klekiMuendling/Motorcycle-chain-oiler-v2/foto/20260508_172321.jpg

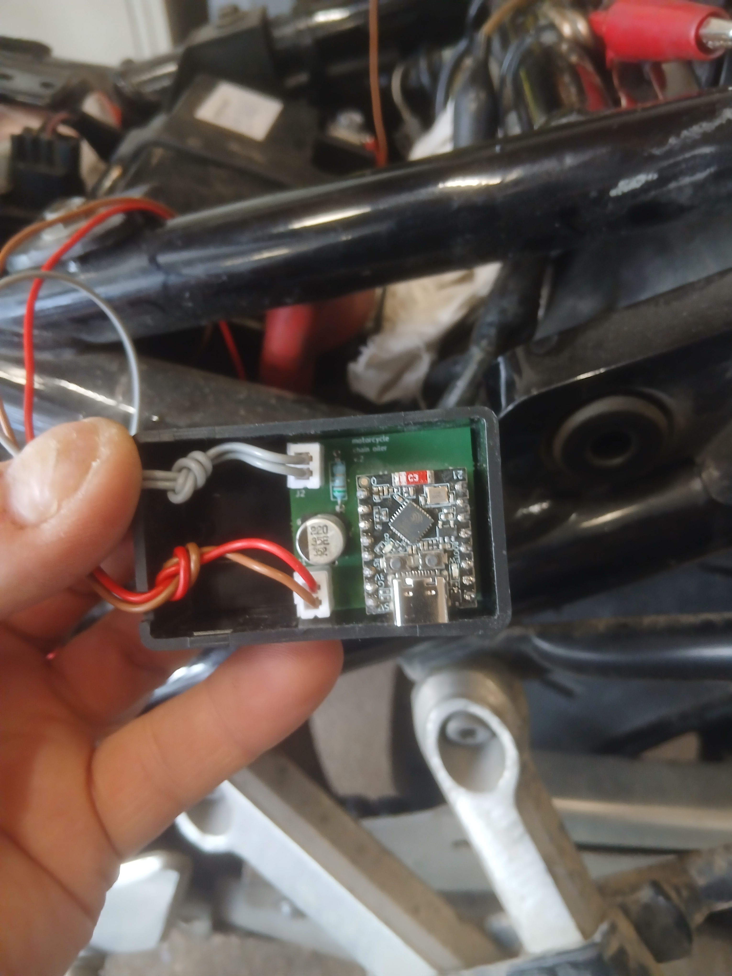
foto/20260508_172321.jpg
