klekiMuendling/Motorcycle-chain-oiler-v2/README.md

# Motorcycle-chain-oiler-v2
Chain oiler for motorbike chain - control PCB with ESP32 controled over Bluetooth
