klekiMuendling/Motorcycle-chain-oiler-v2/motorcycleChainOilerV2/README.md

# motorcycleChainOilerV2

## Description

This is a [LibrePCB](https://librepcb.org) project!
Just edit this file to add a description about it.

## License

No license set.
