klekiMuendling/Motorcycle-chain-oiler-v2/foto/20260508_181641.jpg

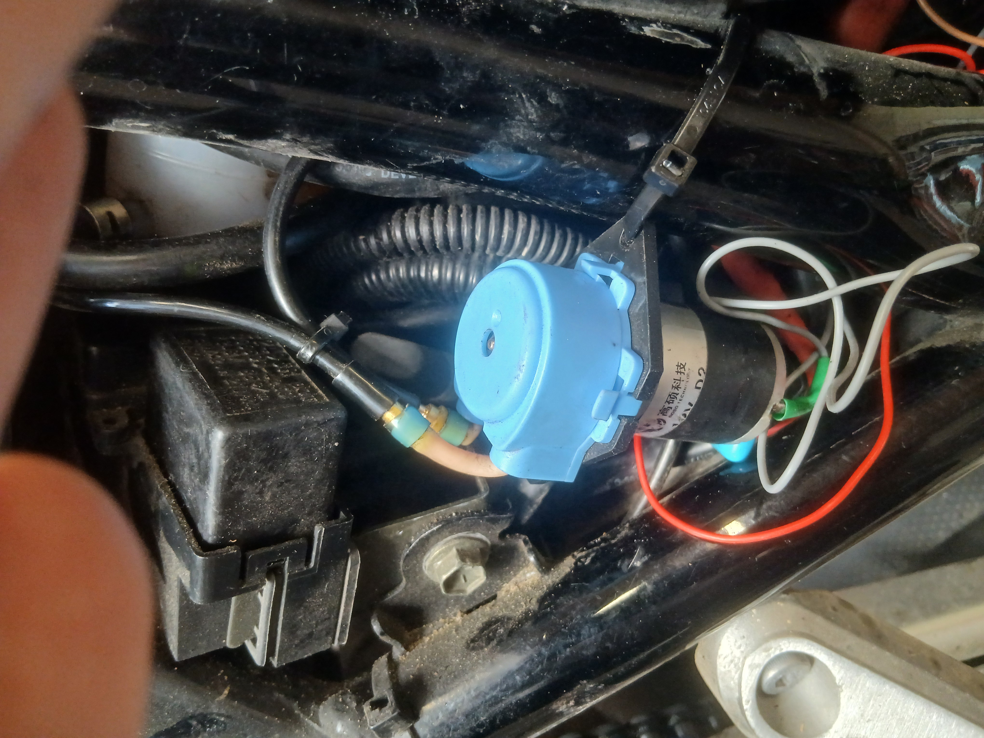
foto/20260508_181641.jpg
