klekiMuendling/Motorcycle-chain-oiler-v2/foto/20260508_182014.jpg

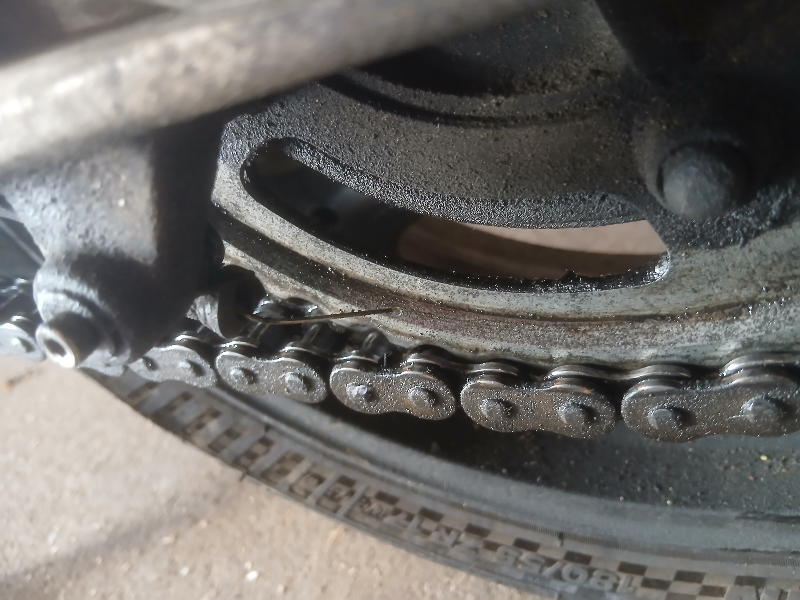
foto/20260508_182014.jpg
