klekiMuendling/Motorcycle-chain-oiler-v2/schematics.pdf

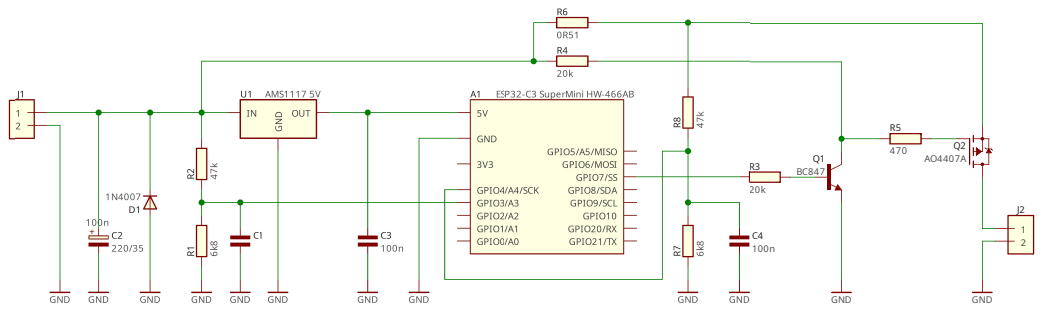
[picture p5: page 1]
GND
