klekiMuendling/Motorcycle-chain-oiler-v2/(commit log)

2026-05-13 PCB project (LibrePCB) added
    Not whole HW is used yet (shunt resistor for pump current measurement) - perhaps sometime in the future.
2026-05-13 ESP32 Arduino application
    Program communicates with smartphone via BT
2026-05-13 some fotos of the device
2026-05-21 ESP32 Arduino application
    Added oil consumption meter
